akreager/APDS-9960_Breakout/README.md

APDS-9960_Breakout
==================
I am attempting to redesign the SparkFun APDS gesture sensor to better fit my needs.
I want to move the sensor as close as possible to the edge of the board and add a voltage regulator and level shifting components to make the board 5V safe.
