akreager/APDS-9960_Breakout/APDS-9960 Breakout/APDS-Breakout.brd

## EAGLE design APDS-9960 Breakout/APDS-Breakout.brd (2014-12-14)

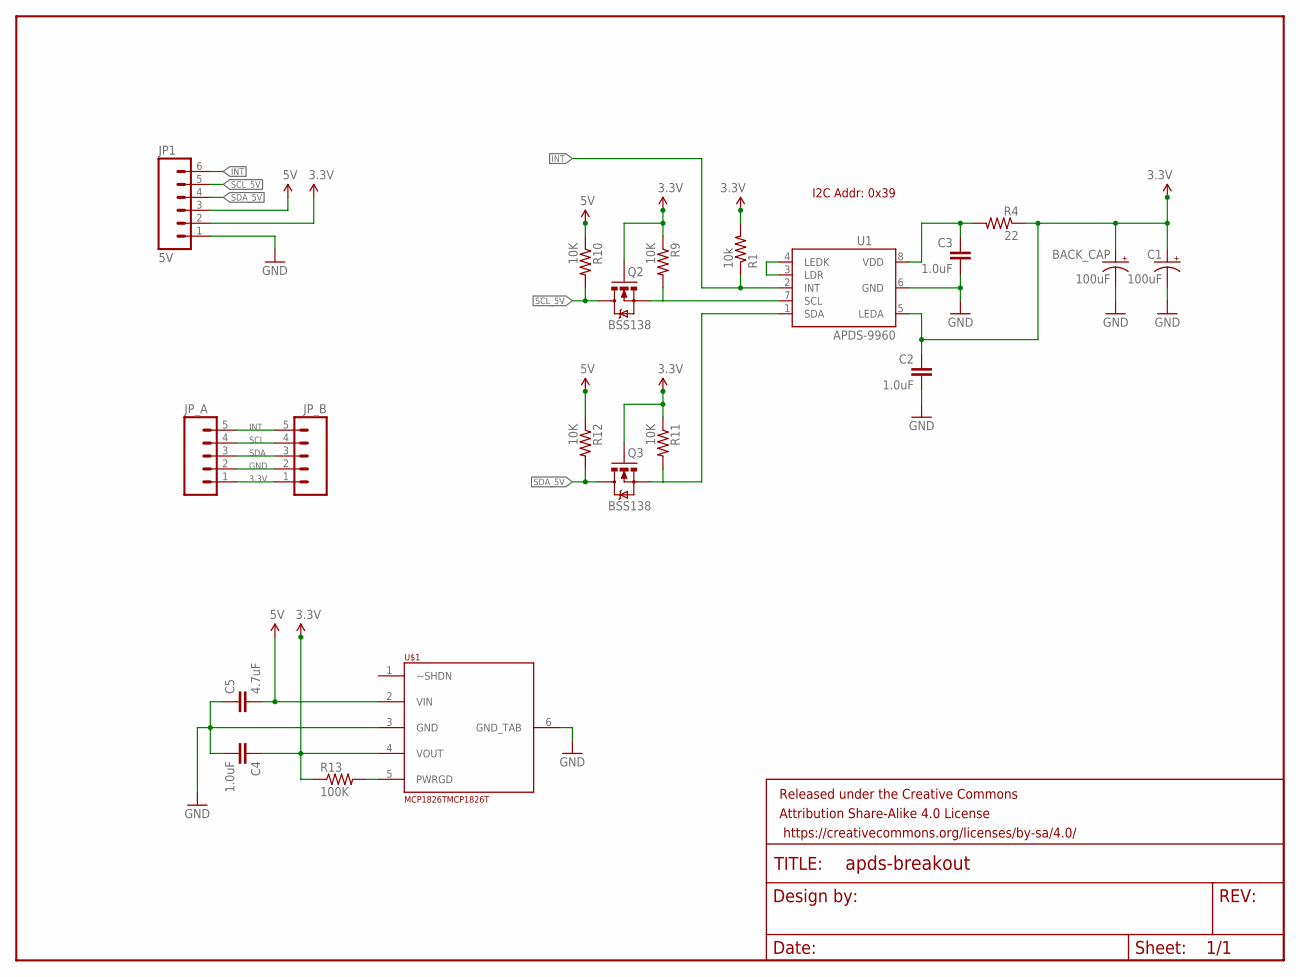
[picture p1: schematic APDS-Breakout.sch]

Parts:
BACK_CAP: 100uF; EIA7343
C1: 100uF; EIA7343
C2, C3, C4: 1.0uF; 0603-CAP
C5: 4.7uF; 0603-CAP
FRAME1: FRAME-LETTER; CREATIVE_COMMONS
JP1: 5V; 1X06_NO_SILK
JP_A: M05PTH; 1X05
JP_B: M05PTH; 1X05
Q2, Q3: BSS138; SOT23-3
R1: 10k; 0603-RES
R4: 22; 0603-RES
R9, R10, R11, R12: 10K; 0603-RES
R13: 100K; 0603-RES
U1: APDS-9960
U$1: MCP1826TMCP1826T; SOP-223-5

Connections:
3.3V: BACK_CAP.A (+), C1.A (+), C2.1, C4.1, JP1.2, JP_A.1, JP_B.1, Q2.1 (G), Q3.1 (G), R1.2, R4.1, R9.1, R11.1, R13.1, U1.5 (LEDA), U$1.4 (VOUT)
5V: C5.2, JP1.3, R10.1, R12.1, U$1.2 (VIN)
GND: BACK_CAP.C (-), C1.C (-), C2.2, C3.2, C4.2, C5.1, JP1.1, JP_A.2, JP_B.2, U1.6 (GND), U$1.3 (GND), U$1.6 (GND_TAB)
INT: JP1.6, JP_A.5, JP_B.5, R1.1, U1.2 (INT)
unnamed: C3.1, R4.2, U1.8 (VDD)
unnamed: U1.3 (LDR), U1.4 (LEDK)
unnamed: R13.2, U$1.5 (PWRGD)
SCL: JP_A.4, JP_B.4, Q2.2 (S), R9.2, U1.7 (SCL)
SCL_5V: JP1.5, Q2.3 (D), R10.2
SDA: JP_A.3, JP_B.3, Q3.2 (S), R11.2, U1.1 (SDA)
SDA_5V: JP1.4, Q3.3 (D), R12.2

Notes on the sheet:
I2C Addr: 0x39

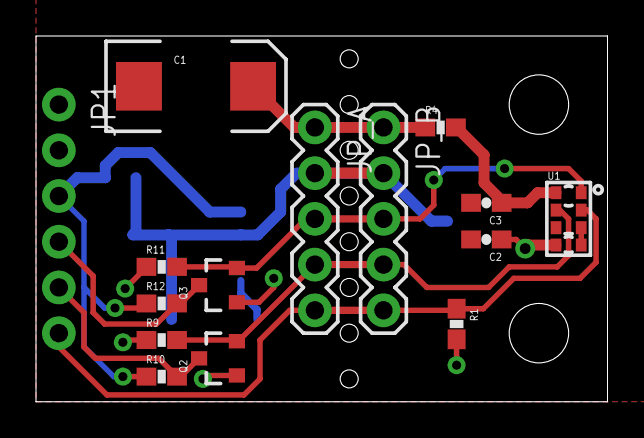
[picture p2: board APDS-Breakout.brd from above]

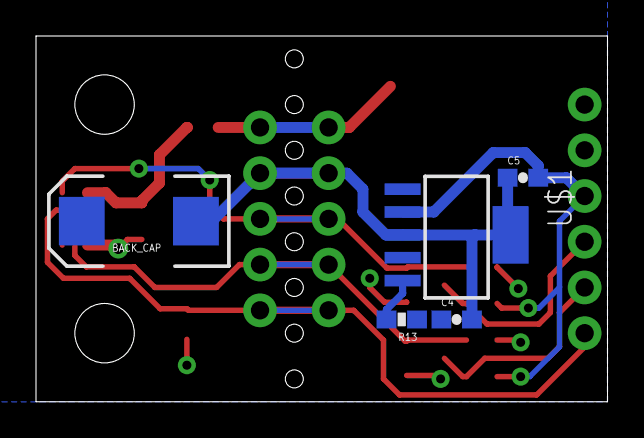
[picture p3: board APDS-Breakout.brd from below]

Board: 2 copper layers, 31.8 x 20.3 mm, 23 parts (5 on the bottom side), 11 nets.

Other parts of the board:
U$2, U$3: STAND-OFF
