akreager/APDS-9960_Breakout/(commit log)

2014-12-06 initial upload
    [APDS-Breakout.brd, APDS-Breakout.sch]
2014-12-14 Initial Design Complete
    Modifications to the SparkFun design (most significant to least):
    1) Rotate and relocate sensor as close as possible to edge of board.
    Reason: I want to be able to put this sensor board into an enclosure
    next to an LCD. The sensor needs to be as close to the LCD for both to
    fit in the window.
    2) Add location on back of board for large electrolytic capacitor.
    Reason: placing the capacitor behind the sensor improves packaging
    options for the board and sensor.
    3) Added voltage regulator and level shifting components to make the
    board 5V safe.
    Reason: Easier to integrate with Arduinos and other 5V micros.
    Note: In my understanding of the APDS datasheet the sensor can pu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
    [APDS-Breakout.brd, APDS-Breakout.sch]
